kepppfeff/Ladebox-2/KiCAD/README.md

Der Schaltplan wurde mit https://kicad.org/ erstellt.

Ein PCB-Layout gibt es derzeit nicht, da die Schaltung auf einer Lochrasterplatine aufgebaut wurde. Um ein PCB-Layout zu erstellen, müsste der Schaltplan auch noch etwas geändert werden, da im Moment alle Komponenten dargestellt sind, auch die, welche gar nicht auf die Platine gehören. Diese müssten somit durch entsprechende Anschlussklemmen bzw. Steckverbinder ersetzt werden. 

Falls jemand Lust haben sollte, ein solches PCB-Layout zu erstellen (ich habe es derzeit nicht vor) und dieses hier zu veröffentlichen, gerne bei mir melden!
