kepppfeff/Ladebox-2/Bilder/ZOE Box Vorderseite.JPG

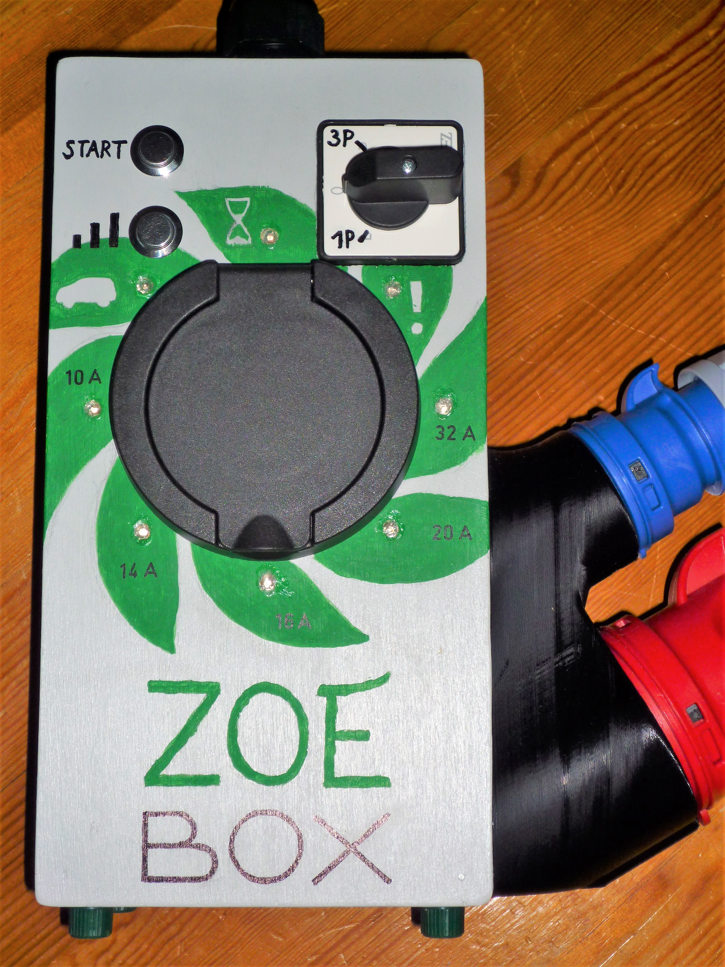
Bilder/ZOE Box Vorderseite.JPG
