kepppfeff/Ladebox-2/Teile und Preise Ladebox 2.6.xlsx

Teileliste: Mobile Ladebox (Hardware-Version 2.6) inkl. 2 Adapterkabel
In der folgenden Tabelle habe ich alle Produkte zusammengestellt, die ich heute kaufen würde, um (noch) eine mobile Ladebox zu bauen.
Teilweise habe ich selbst andere Produkte verwendet als die aufgelisteten, da ich diese gerade da hatte, oder ich habe die aufgelisteten Produkte bei anderen Händlern bestellt.
Daher keine Garantie, dass alle Produkte korrekt ausgewählt sind und alle Links stimmen.
Sollte irgendetwas nicht korrekt sein, würde ich mich über eine Nachricht freuen, damit ich dies korrigieren kann.
Ich habe überall, wo es mir möglich war, Links zu möglichst günstigen Online-Angeboten hinzugefügt (es sind übrigens keine Affiliate-Links) und die entsprechenden Preise angegeben.
Die Preise können sich selbstverständlich bei den Online-Shops jederzeit ändern und sind somit nur für einen groben Überblick gedacht.
Die Versandkosten habe ich pro Shop jeweils nur einmal eingetragen (fett) und bei allen weiteren Produkten mit 0,00 € berechnet.
Einige Produkte habe ich von chinesischen Händlern über AliExpress ausgewählt. Alle kosten (deutlich) unter 22 € und sind damit frei von Einfuhrumsatzsteuer.
Der Versand dauert in der Regel mehrere Wochen. Falls eine Bestellung aus China nicht erwünscht ist, habe ich unten passende Alternativen aufgelistet.
Verwen-dungszweck | Bezeichung | Anz. | Einzel-preis | Versand | Gesamt-preis | Bezugsquelle | Artikelnummer | Weblink
Strom-versorgung der Steuer-platine | DC/DC-Step-Down-Wandler (Eingang 6,8–28 V, Ausgang 5V 500 mA) | 1 | 2.73 € | 5.80 € | 8.53 € | Reichelt / Voelkner | LC78_05-0.5 / X728901 | https://www.reichelt.de/dc-dc-wandler-2-5-w-5-v-500-ma-to-220-lc78-05-0-5-p242823.html oder https://www.voelkner.de/products/1038823/Gaptec-LC7805-0.5-DC-DC-Wandler-Print-12-V-DC-5-V-DC-500mA-2.5W-Anzahl-Ausgaenge-1-x.html
 | Mean Well Netzteil APV-8-12 (12 V, 8 W) | 1 | 4.60 € | 5.95 € | 10.55 € | Voelkner | W201541 | https://www.voelkner.de/products/902679/Mean-Well-APV-8-12-LED-Trafo-Konstantspannung-8W-0-0.67A-12-V-DC-nicht-dimmbar-Ueberlastschutz.html
 | Ladungspumpe ICL7660A (nicht ICL7660 !) | 1 | 1.36 € | 0.00 € | 1.36 € | Reichelt | ICL 7660 ACPAZ | https://www.reichelt.de/dc-dc-einstellbar-1-5--12-v-1-5--12-v-dil-8-icl-7660-acpaz-p188882.html
 | Keramik-(Stütz-)Kondensator 100 nF | 3 | 0.05 € | 0.00 € | 0.15 € | Reichelt | KERKO 100N | https://www.reichelt.de/keramik-kondensator-100n-kerko-100n-p9265.html
 | Elektrolyt-Kondensator 22 μF, low ESR | 4 | 0.09 € | 0.00 € | 0.36 € | Reichelt | RAD FR 22/50 | https://www.reichelt.de/elko-radial-22-uf-50-v-105-c-low-esr-rad-fr-22-50-p121288.html
Stecker-verrie-gelung | Relais, 1 Wechsler, Spule 12 V/DC | 2 | 0.67 € | 0.00 € | 1.34 € | Reichelt | HJR-4102-L 12V | https://www.reichelt.de/dil-miniaturrelais-hjr-4102-12v-1-wechsler-5a-hjr-4102-l-12v-p101951.html
 | Elektrolyt-Kondensator 4700 μF, low ESR | 1 | 0.90 € | 0.00 € | 0.90 € | Voelkner | D05780 | https://www.voelkner.de/products/543368/Panasonic-EEUFR1C472B-Elektrolyt-Kondensator-radial-bedrahtet-7.5mm-4700-F-16V-20-x-H-16mm-x-25mm-1St..html
 | NPN-Transistor BD139 (1,5 A) | 1 | 0.14 € | 0.00 € | 0.14 € | Reichelt | BD 139-16 | https://www.reichelt.de/bipolartransistor-npn-80v-1-5a-8w-to-126-bd-139-16-p219090.html
 | Verriegelungsaktuator für Typ2-Dose | 1 | 25.00 € | 9.00 € | 34.00 € | Laadkabelwinkel | 99051000801 | https://www.laadkabelwinkel.nl/dsiec-elb-electromagnetic-lock
 | NPN-Transistor BC547C | 3 | 0.02 € | 0.00 € | 0.06 € | Reichelt | BC 547C | https://www.reichelt.de/bipolartransistor-npn-45v-0-1a-0-5w-to-92-bc-547c-p5007.html
 | Widerstand 2,2 Ω | 1 | 0.04 € | 0.00 € | 0.04 € | Reichelt | VI MBB02070C2208 | https://www.reichelt.de/duennschichtwiderstand-axial-0-6-w-2-2-ohm-1--vi-mbb02070c2208-p233710.html
 | Schottky-Diode 1N5817 | 1 | 0.02 € | 0.00 € | 0.02 € | Reichelt | RND 1N5817 | https://www.reichelt.de/schottkydiode-20-v-1-a-do-41-rnd-1n5817-p223383.html
Erzeugung und Auswertung Pilotsignal | Komparator LM393 (2-fach) | 1 | 0.18 € | 0.00 € | 0.18 € | Reichelt | LM 393 DIP | https://www.reichelt.de/komparator-2-fach-dip-8-lm-393-dip-p10510.html
 | Operationsverstärker LM6132 (2-fach, rail-to-rail) | 1 | 3.36 € | 0.00 € | 3.36 € | Reichelt | LM 6132 BIN | https://www.reichelt.de/operationsverstaerker-dual-10-mhz-dil-8-lm-6132-bin-p187779.html
 | Schottky-Diode BAT85 | 2 | 0.08 € | 0.00 € | 0.16 € | Reichelt | BAT 85 | https://www.reichelt.de/schottkydiode-30-v-0-2-a-do-35-bat-85-p4857.html
 | PNP-Transistor BC557B | 1 | 0.02 € | 0.00 € | 0.02 € | Reichelt | BC 557B | https://www.reichelt.de/bipolartransistor-pnp-45v-0-1a-0-5w-to-92-bc-557b-p35845.html
Bedienung und Anzeige | LED grün | 8 | 0.06 € | 0.00 € | 0.48 € | Reichelt | RND 135-00172 | https://www.reichelt.de/led-5-mm-gelb-gruen-einfarbig-1700-mcd-15--rnd-135-00172-p263822.html
 | Taster – Metallgehäuse muss geerdet werden! | 2 | 4.60 € | 0.00 € | 9.20 € | Voelkner | D79675 oder D79021 | https://www.voelkner.de/products/73350/TRU-Components-GQ16F-10-J-N-Vandalismusgeschuetzter-Drucktaster-48-V-DC-2A-1-x-Aus-Ein-IP65-tastend-1St..html oder https://www.voelkner.de/products/73410/TRU-Components-GQ16B-10-J-N-Vandalismusgeschuetzter-Drucktaster-48-V-DC-2A-1-x-Aus-Ein-IP65-tastend-1St..html
 | Schalter 3 × Ein-Aus-Ein (3 Wechsler) – Metallgehäuse muss geerdet werden! | 1 | 6.70 € | 0.00 € | 6.70 € | Voelkner | D77757 oder D73953 | https://www.voelkner.de/products/41958/APEM-5559A-55590003-Kippschalter-250-V-AC-3A-3-x-Ein-Aus-Ein-rastend-0-rastend-1St..html oder https://www.voelkner.de/products/43531/Eledis-1A33-NF1STSE-Kippschalter-250-V-AC-2A-3-x-Ein-Aus-Ein-rastend-0-rastend-1St..html
Allge-meines | Chinesischer Arduino Nano Klon | 1 | 1.75 € | 0.00 € | 1.75 € | AliExpress | 32855188188 | z.B. https://de.aliexpress.com/item/32855188188.html (eine der Varianten mit 328P wählen)
 | Widerstände (8× 150 Ω, 4× 1 kΩ, 2× 4,7 kΩ, 3× 22 kΩ, 3× 68 kΩ, 1× 82 kΩ, 3× 120 kΩ, 1× 220 kΩ) | 25 | 0.03 € | 0.00 € | 0.75 € | Reichelt | VI MBB02070C… | https://www.reichelt.de/Duennschichtwiderstaende/2/index.html?ACTION=2&LA=2&GROUPID=8367
 | Silizium-Diode 1N4007 | 7 | 0.02 € | 0.00 € | 0.14 € | Reichelt | 1N 4007 DIO | https://www.reichelt.de/gleichrichterdiode-1000-v-1-a-do-41-1n-4007-dio-p219368.html
 | Verbrauchsmaterial (Aderendhülsen, Schrumpfschläuche, Drähte, Lötzinn usw.) | ? | ? | ? | 3.00 € | ? |  | Nach Bedarf, Preis geschätzt
Platine und elektrische Verbin-dungen | IC-Sockel DIP-8 (falls gewünscht) | 3 | 0.04 € | 0.00 € | 0.12 € | Reichelt | GS 8 | https://www.reichelt.de/ic-sockel-8-polig-doppelter-federkontakt-gs-8-p8230.html
 | Lochrasterplatine | 1 | 1.99 € | 0.00 € | 1.99 € | Reichelt | H25PR150 | https://www.reichelt.de/lochrasterplatine-hartpapier-150x100mm-h25pr150-p8271.html
 | Ein Schwung Buchsenleisten 1 × 15 für Arduino Nano (2 Stück werden benötigt) | 1 | 0.30 € | 1.00 € | 1.30 € | AliExpress | ? | Hier suchen: https://de.aliexpress.com/wholesale?trafficChannel=main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
 | Klemm- / Schraubblöcke, Steckverbinder und Leitungen | ? | ? | ? | 8.00 € | ? |  | Nach Bedarf, Preis geschätzt
Netz-spannungs-Teile | Typ2-Ladesteckdose 32 A (mit Schraubanschlüssen) | 1 | 90.00 € | 0.00 € | 90.00 € | Laadkabelwinkel | 99051000781 | https://www.laadkabelwinkel.nl/type-2-socket-16a-32a-schroefverbinding
 | Wago-Klemme 221-415 (5 × bis 4 mm²) | 1 | 0.81 € | 0.00 € | 0.81 € | Reichelt / Voelkner | WAGO 221-415 / Q661261 | https://www.reichelt.de/verbindungsklemme-5-leiteranschluss-wago-221-415-p149800.html oder https://www.voelkner.de/products/699424/WAGO-Verbindungsklemme-flexibel-0.14-4mm-starr-0.2-4mm-Polzahl-5-221-415-1-St.-Transparent-Orange.html
 | Wago-Klemme 221-413 (3 × bis 4 mm²) | 4 | 0.50 € | 0.00 € | 2.00 € | Reichelt / Voelkner | WAGO 221-413 / Q661241 | https://www.reichelt.de/verbindungsklemme-3-leiteranschluss-wago-221-413-p149799.html oder https://www.voelkner.de/products/699423/WAGO-221-413-1-Verbindungsklemme-flexibel-0.14-4mm-starr-0.2-4mm-Polzahl-3-Transparent-Orange.html
 | Wago-Klemme 222-413 (3 × bis 2,5 mm²) | 3 | 0.39 € | 0.00 € | 1.17 € | Reichelt / Voelkner | WAGO 222-413 / S55241 | https://www.reichelt.de/verbindungsdosenklemme-3-fach-0-08-4-0mm--wago-222-413-p54547.html oder https://www.voelkner.de/products/2306/WAGO-Verbindungsklemme-flexibel-0.08-4mm-starr-0.08-2.5mm-Polzahl-3-222-413-1-St.-Grau-Orange.html
 | Doepke DFS 4 040-4/0,03-A EV (9134818) | 1 | 253.33 € | 6.90 € | 260.23 € | VOLTUS | 1683383 | https://www.voltus.de/elektromaterial/e-mobilitaet/doepke/doepke-09134818-dfs-4-040-4-0-03-a-ev-fehlerstromschutzschalter-typ-a-4-polig-40a.html
 | Schmelzsicherung 400 mA träge | 1 | 0.22 € | 0.00 € | 0.22 € | Reichelt | MIK-TR 0,4A | https://www.reichelt.de/kleinstsicherung-kurz-traege-0-4a-mik-tr-0-4a-p125191.html
Gehäuse | Holzteile und Schrauben | ? | ? | ? | 8.00 € | Baumarkt des Vertrauens
 | Kabelverschraubung M25 (für 5 × 4 mm²) | 1 | 0.35 € | 0.00 € | 0.35 € | Reichelt | MBF 25 | https://www.reichelt.de/metrische-kabelverschraubung-11-0-17-0-mm-m25-grau-mbf-25-p44828.html
 | Gegenmutter für Kabelverschr. M25 | 1 | 0.10 € | 0.00 € | 0.10 € | Reichelt | MGM 25 | https://www.reichelt.de/metrische-gegenmutter-fuer-mbf-25-m25-grau-mgm-25-p44833.html
 | Kabelverschraubung M20 (für 3 × 2,5 mm²) | 1 | 0.25 € | 0.00 € | 0.25 € | Reichelt | MBF 20 | https://www.reichelt.de/metrische-kabelverschraubung-8-0-13-0-mm-m20-grau-mbf-20-p44827.html
 | Gegenmutter für Kabelverschr. M20 | 1 | 0.07 € | 0.00 € | 0.07 € | Reichelt | MGM 20 | https://www.reichelt.de/metrische-gegenmutter-fuer-mbf-20-m20-grau-mgm-20-p44832.html
Anschluss- und Adapter-kabel | Drehstrom-Stecker CEE32 (rot) | 1 | 4.20 € | 0.00 € | 4.20 € | Reichelt | CEE-STECKER 2-32 | https://www.reichelt.de/5-poliger-cee-stecker-400v-32a-rot-cee-stecker-2-32-p29106.html
 | Camping-Stecker CEE16 (blau) | 1 | 2.30 € | 0.00 € | 2.30 € | Voelkner | X96210 | https://www.voelkner.de/products/80233/PCE-172500009-CEE-CARA-Stecker-16A-3polig-230V.html
 | Drehstrom-Stecker CEE16 (rot) | 1 | 2.65 € | 0.00 € | 2.65 € | Reichelt | CEE-STECKER 2-16 | https://www.reichelt.de/cee-stecker-400v-16a-rot-5-polig-cee-stecker-2-16-p29105.html
 | Drehstrom-Kupplung CEE32 (rot) | 1 | 4.00 € | 0.00 € | 4.00 € | Voelkner / Reichelt | X96291 / CEE-KUPP 2-32 | https://www.voelkner.de/products/8020/PCE-225-6-CEE-Kupplung-32A-5polig-400V.html oder https://www.reichelt.de/cee-kupplung-400v-32a-rot-cee-kupp-2-32-p29109.html
 | Camping-Kupplung CEE16 (blau) | 1 | 3.00 € | 0.00 € | 3.00 € | Voelkner / Reichelt | X96234 / CEE-KUPP 1-16 | https://www.voelkner.de/products/80234/PCE-182400003-CEE-CARA-Kupplung-16A-3polig-230V.html oder https://www.reichelt.de/cee-kupplung-230v-16a-blau-cee-kupp-1-16-p29107.html
 | Schutzkontaktstecker (CEE 7/7, kompa-tibel auch mit französischen Steckdosen) | 1 | 2.20 € | 0.00 € | 2.20 € | Reichelt | TAUR2 0521-SR | https://www.reichelt.de/gummi-stecker-taurus2-typ-ef-cee-7-7-schwarz-rot-taur2-0521-sr-p277259.html
 | Gummileitung 5 × 4 mm² (Meterware) | 1 | 4.36 € | 0.00 € | 4.36 € | VOLTUS | 1010909 | https://www.voltus.de/elektromaterial/kabel/gummi-leitung/schwer-h07rnf/h07rn-f-5g4qmm-gummischlauchleitungen-schwere-nennspannung-450-750v-meterware.html
 | Gummileitung 5 × 2,5 mm² (Meterware) | 1 | 2.20 € | 0.00 € | 2.20 € | VOLTUS | 1010907 | https://www.voltus.de/elektromaterial/kabel/gummi-leitung/schwer-h07rnf/h07rn-f-5g2-5qmm-gummischlauchleitungen-schwere-nennspannung-450-750v-meterware.html
 | Gummileitung 3 × 2,5 mm² (Meterware) | 2 | 1.40 € | 0.00 € | 2.80 € | VOLTUS | 1010882 | https://www.voltus.de/elektromaterial/kabel/gummi-leitung/schwer-h07rnf/h07rn-f-3g2-5qmm-gummischlauchleitungen-schwere-nennspannung-450-750v.html
Schalten des Ladestroms | Schütz ABB ESB 40-40 230AC/DC | 1 | 25.00 € | 5.00 € | 30.00 € | ? |  | https://www.idealo.de/preisvergleich/OffersOfProduct/1192024_-esb-40-40-230vac-dc-abb-stotz-striebel-john.html
 | Relais, 1 Schließer, 30 A, Spule 12 V/DC | 2 | 1.10 € | 0.00 € | 2.20 € | Voelkner | W225001 | https://www.voelkner.de/products/942274/SHA-T90-SHA-12VDC-S-A-4pin-Printrelais-12-V-DC-30A-1-Schliesser-1St..html
 | Relais, 1 Schließer, Spule 12 V/DC | 1 | 0.67 € | 0.00 € | 0.67 € | Reichelt | HJR-4102-L 12V | https://www.reichelt.de/dil-miniaturrelais-hjr-4102-12v-1-wechsler-5a-hjr-4102-l-12v-p101951.html
 | NPN-Transistor BC337-40 | 1 | 0.03 € | 0.00 € | 0.03 € | Reichelt | BC 337-40 | https://www.reichelt.de/bipolartransistor-npn-45v-0-8a-0-625w-to-92-bc-337-40-p4987.html
 | Gesamtkosten: |  |  | 518.41 €
Alternative Produkte
 | Bezeichung | Anz. | Einzel-preis | Versand | Gesamt-preis | Bezugsquelle | Artikelnummer | Weblink
Folgende Produkte können verwendet werden, falls nicht bei chinesischen Händlern bestellt werden soll:
Statt Zeile 40 | Alternative 1: Chinesischer Arduino-Nano-Klon von deutschem Händler | 1 | 3.85 € | 0.00 € | 3.85 € | eBay | 274450834212 | https://www.ebay.de/itm/274450834212
 | Alternative 2: Marken-Arduino-Nano-Klon | 1 | 11.55 € | 0.00 € | 11.55 € | Reichelt | ARD NANO V3 | https://www.reichelt.de/arduino-kompatibles-nano-board-atmega328-mini-usb-ard-nano-v3-p225690.html
 | Alternative 3: Original Arduino Nano | 1 | 17.00 € | 0.00 € | 17.00 € | Reichelt | ARDUINO NANO | https://www.reichelt.de/arduino-nano-v3-3-atmega-328-mini-usb-arduino-nano-p142943.html
Statt Zeile 47 | Zwei Buchsenleisten 1 × 15 für Arduino Nano (Mindestbestellmenge: 10) | 10 | 0.30 € | 0.00 € | 3.00 € | Voelkner | W052741 | https://www.voelkner.de/products/955307/Econ-Connect-Buchsenleiste-Standard-Anzahl-Reihen-1-Polzahl-je-Reihe-15-BLG1X15-1St..html
Die folgenden Bauteile können anstatt der fest verlöteten Schmelzsicherung (Zeile 55) verwendet werden, um die Sicherung bei Auslösung einfacher austauschen zu können:
 | Sicherungshalter Printmontage | 1 | 0.19 € | 0.00 € | 0.19 € | Reichelt | RND 170-00188 | https://www.reichelt.de/sicherungshalter-fuer-5-x-20-mm-250-v-6-3-a-gruen-rnd-170-00188-p253173.html
 | Feinsicherung 5 × 20 mm, 400 mA träge | 1 | 0.32 € | 0.00 € | 0.32 € | Reichelt | TR 0,4A | https://www.reichelt.de/feinsicherung-5x20mm-traege-0-4a-tr-0-4a-p21783.html
