kepppfeff/Ladebox-2/Schaltplan Ladebox 2.6.pdf

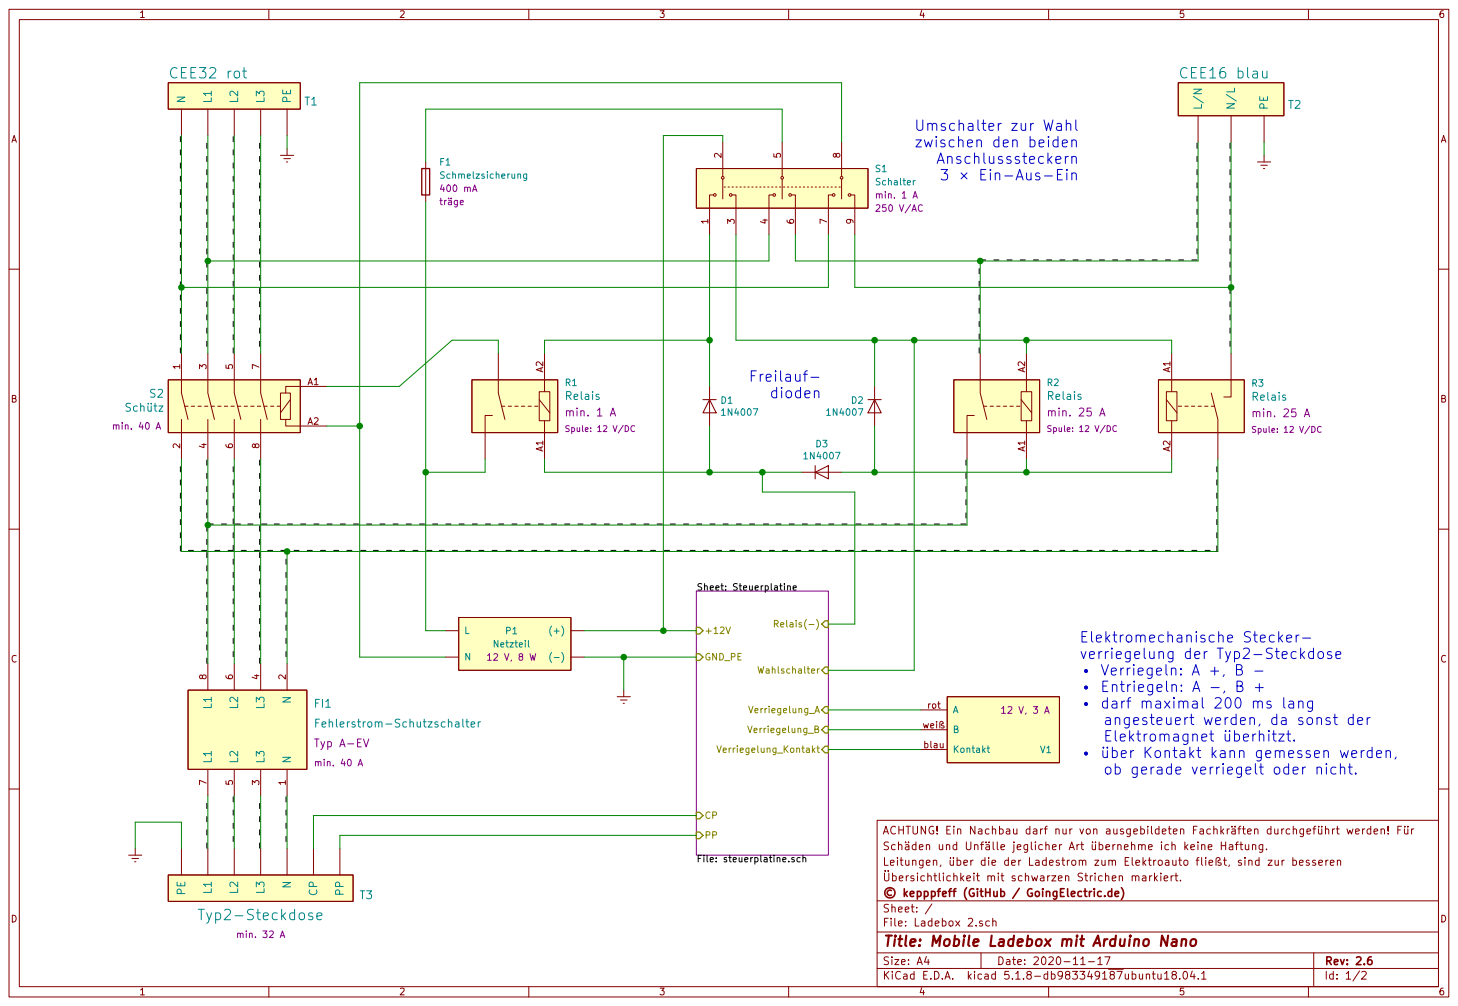
[picture p8: page 1]

Elektromechanische Stecker-
verriegelung der Typ2-Steckdose
Verriegeln: A +, B -
Entriegeln: A -, B +
darf maximal 200 ms lang
angesteuert werden, da sonst der
Elektromagnet überhitzt.
über Kontakt kann gemessen werden,
ob gerade verriegelt oder nicht.

File: steuerplatine.sch CP

ACHTUNG! Ein Nachbau darf nur von ausgebildeten Fachkräften durchgeführt werden! Für
Schäden und Unfälle jeglicher Art übernehme ich keine Haftung.
Leitungen, über die der Ladestrom zum Elektroauto fließt, sind zur besseren
Übersichtlichkeit mit schwarzen Strichen markiert.
File: Ladebox 2.sch Sheet: / © kepppfeff (GitHub / GoingElectric.de)

Id: 1/2 Title: Mobile Ladebox mit Arduino Nano

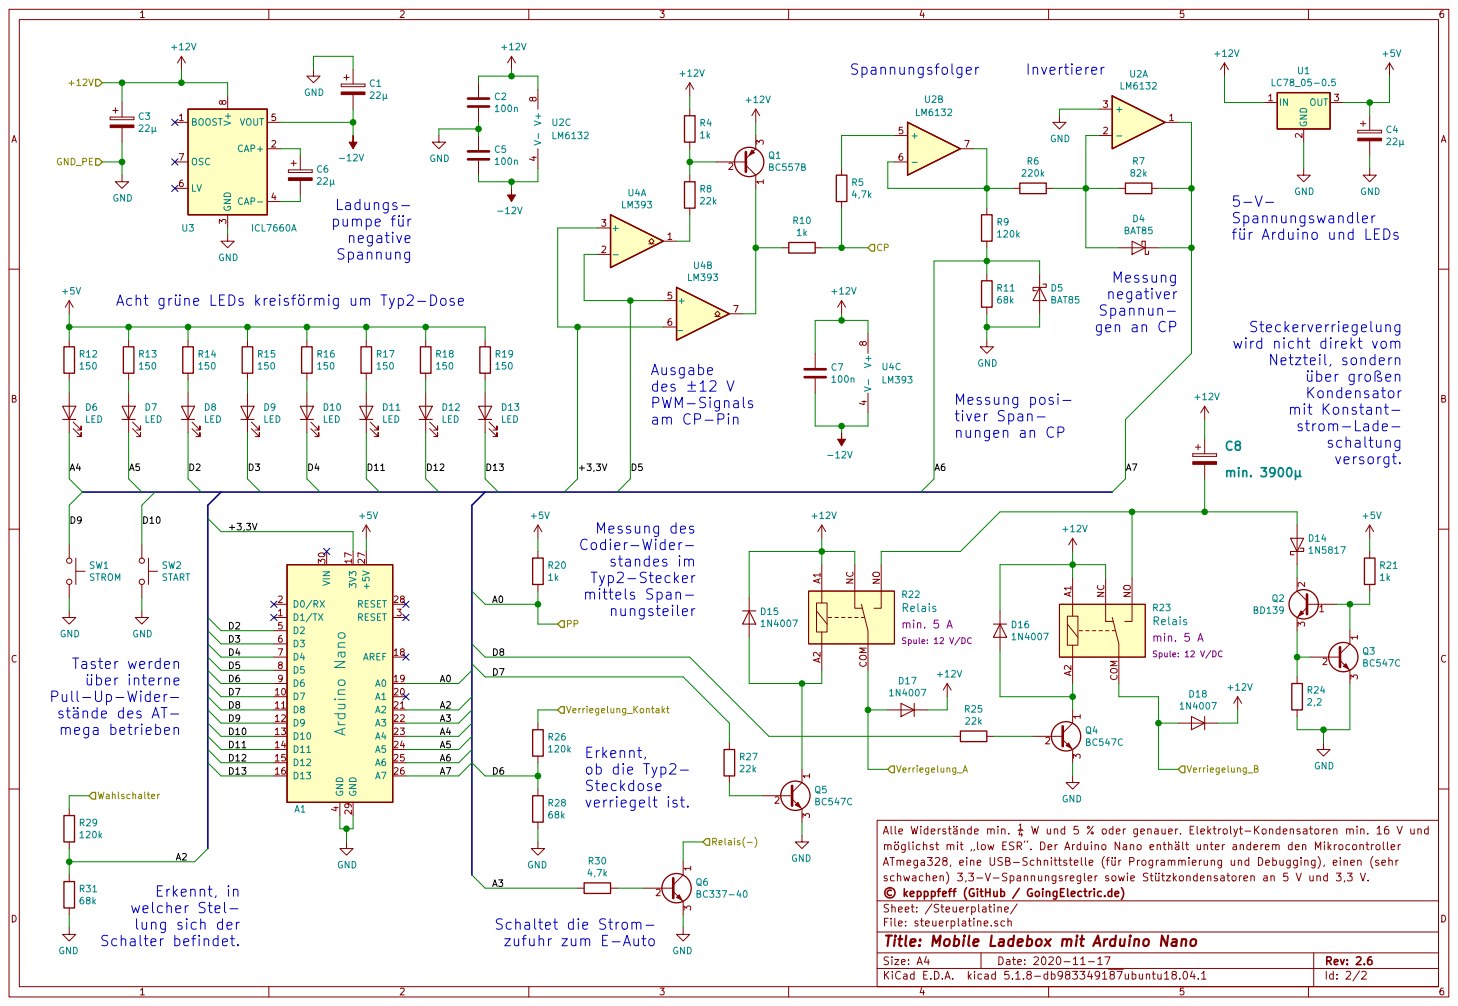
[picture p9: page 2]

R22 Relais Spule: 12 V/DC min. 5 A V- 4 V+

Acht grüne LEDs kreisförmig um Typ2-Dose

Alle Widerstände min. ¼ W und 5 % oder genauer. Elektrolyt-Kondensatoren min. 16 V und D10
LED

R23 Relais Spule: 12 V/DC min. 5 A

möglichst mit low ESR. Der Arduino Nano enthält unter anderem den Mikrocontroller
ATmega328, eine USB-Schnittstelle (für Programmierung und Debugging), einen (sehr
schwachen) 3,3-V-Spannungsregler sowie Stützkondensatoren an 5 V und 3,3 V.
© kepppfeff (GitHub / GoingElectric.de)
Sheet: /Steuerplatine/
File: steuerplatine.sch
Id: 2/2 Title: Mobile Ladebox mit Arduino Nano
