kepppfeff/Ladebox-2/KiCAD/Ladebox 2.sch

## KiCad design KiCAD/Ladebox 2.sch (2020-11-17)

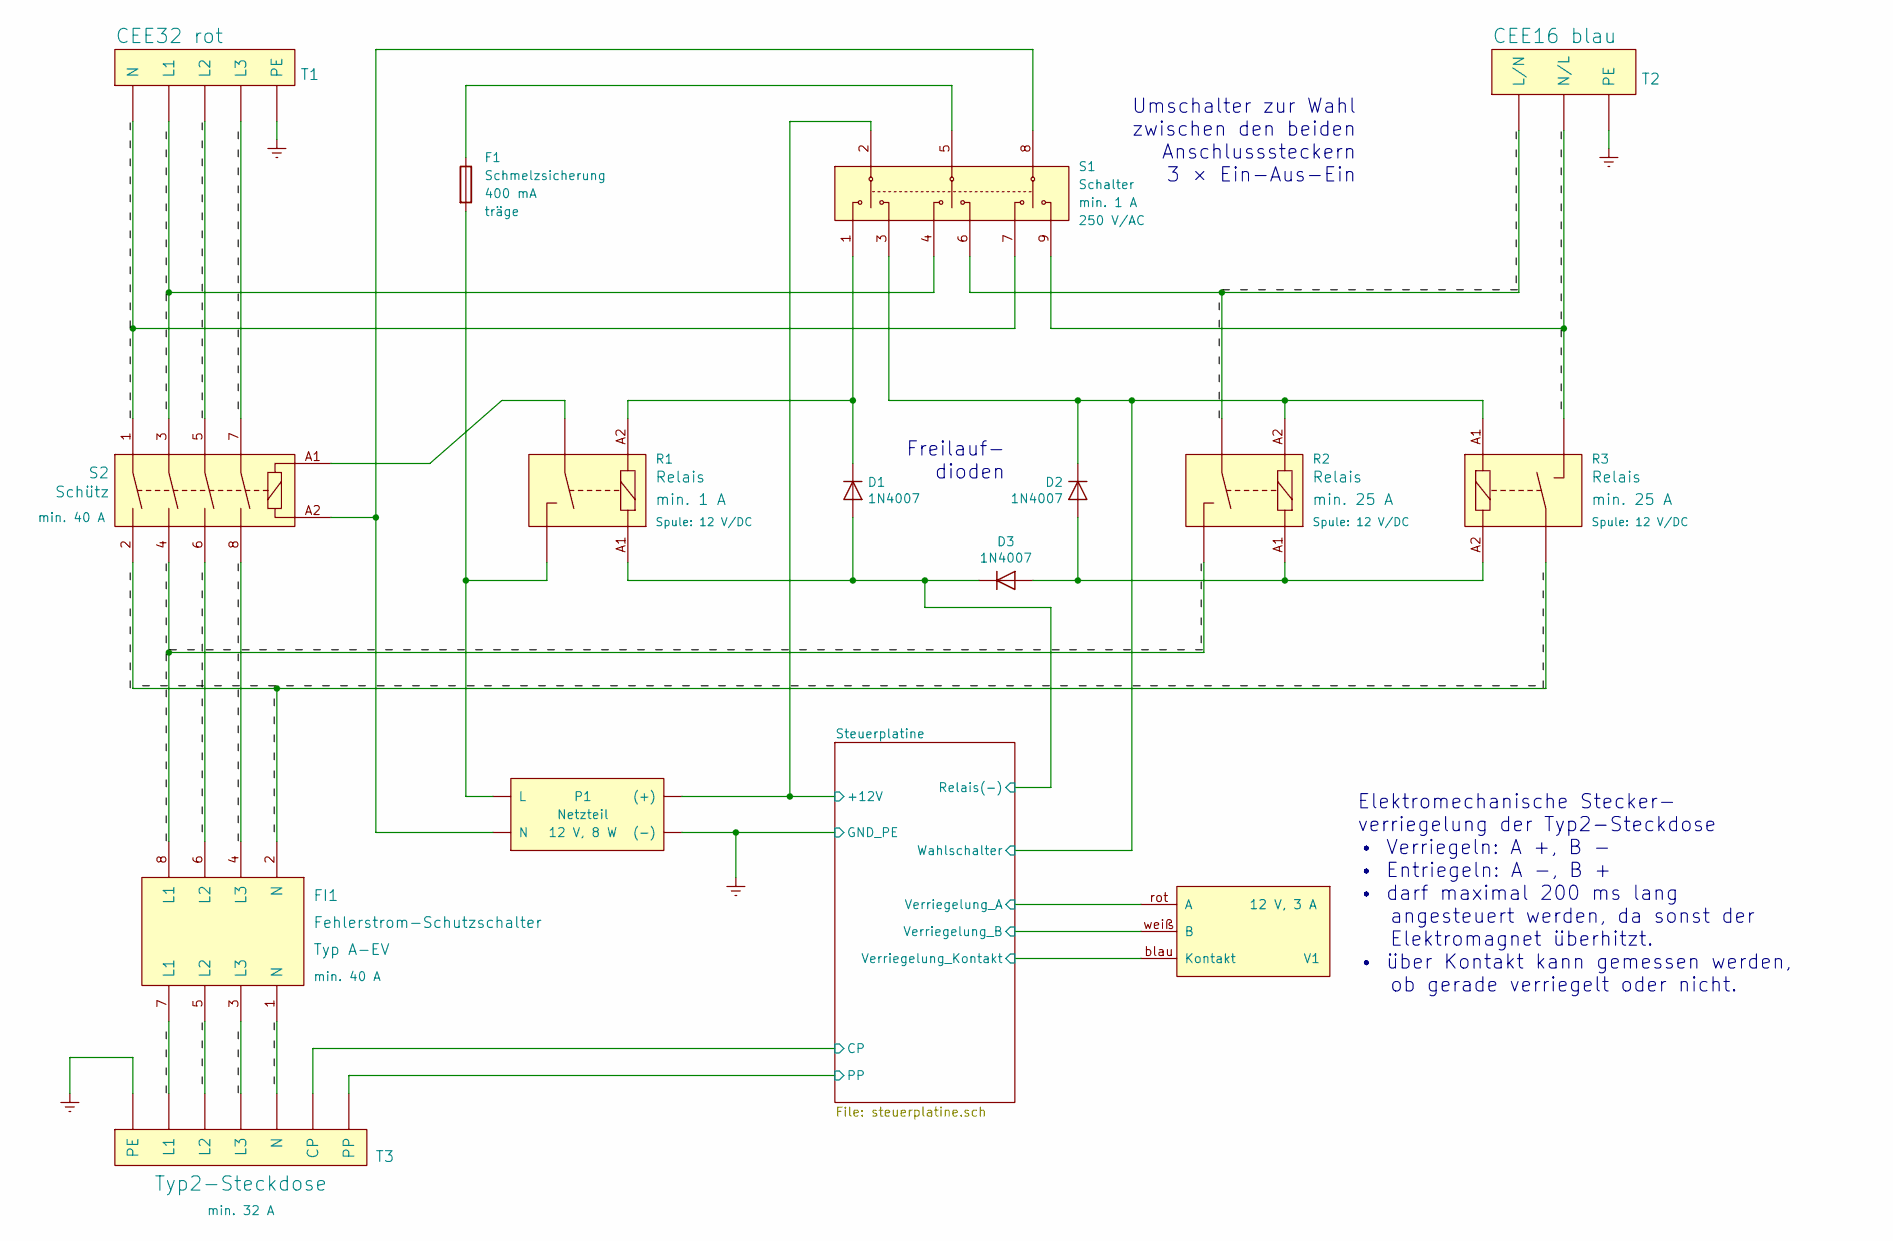
[picture p10: schematic Ladebox 2.sch]

Parts:
D1, D2, D3: 1N4007
F1: Schmelzsicherung
FI1: Fehlerstrom-Schutzschalter
P1: Netzteil
R1, R2, R3: Relais
S1: Schalter
S2: Schütz
T1: CEE32 rot
T2: CEE16 blau
T3: Typ2-Steckdose
V1: Verriegelung

Connections:
+12V: P1.~, S1.2
CP: T3.~
Earth: P1.~, T1.~, T2.~, T3.~
unnamed: D1.1 (K), R1.A2, S1.1
unnamed: D2.2 (A), D3.2 (A), R2.A1, R3.A2
unnamed: F1.1, S1.5
unnamed: F1.2, P1.~, R1.~
unnamed: P1.~, S1.8, S2.A2
unnamed: R1.~, S2.A1
PP: T3.~
Relais(-): D1.2 (A), D3.1 (K), R1.A1
Verriegelung_A: V1.rot (A)
Verriegelung_B: V1.weiß (B)
Verriegelung_Kontakt: V1.blau (Kontakt)
Wahlschalter: D2.1 (K), R2.A2, R3.A1, S1.3
_: FI1.1 (N), FI1.2 (N), FI1.3 (L3), FI1.4 (L3), FI1.5 (L2), FI1.6 (L2), FI1.7 (L1), FI1.8 (L1), R2.~, R3.~, S1.4, S1.6, S1.7, S1.9, S2.1, S2.2, S2.3, S2.4, S2.5, S2.6, S2.7, S2.8, T1.~, T2.~, T3.~

Notes on the sheet:
Elektromechanische Stecker- verriegelung der Typ2-Steckdose • Verriegeln: A +, B - • Entriegeln: A -, B + • darf maximal 200 ms lang angesteuert werden, da sonst der Elektromagnet überhitzt. • über Kontakt kann gemessen werden, ob gerade verriegelt oder nicht.
Umschalter zur Wahl zwischen den beiden Anschlusssteckern 3 × Ein-Aus-Ein
Freilauf- dioden
