kepppfeff/Ladebox-2/KiCAD/steuerplatine.sch

## KiCad design KiCAD/steuerplatine.sch (2020-11-17)

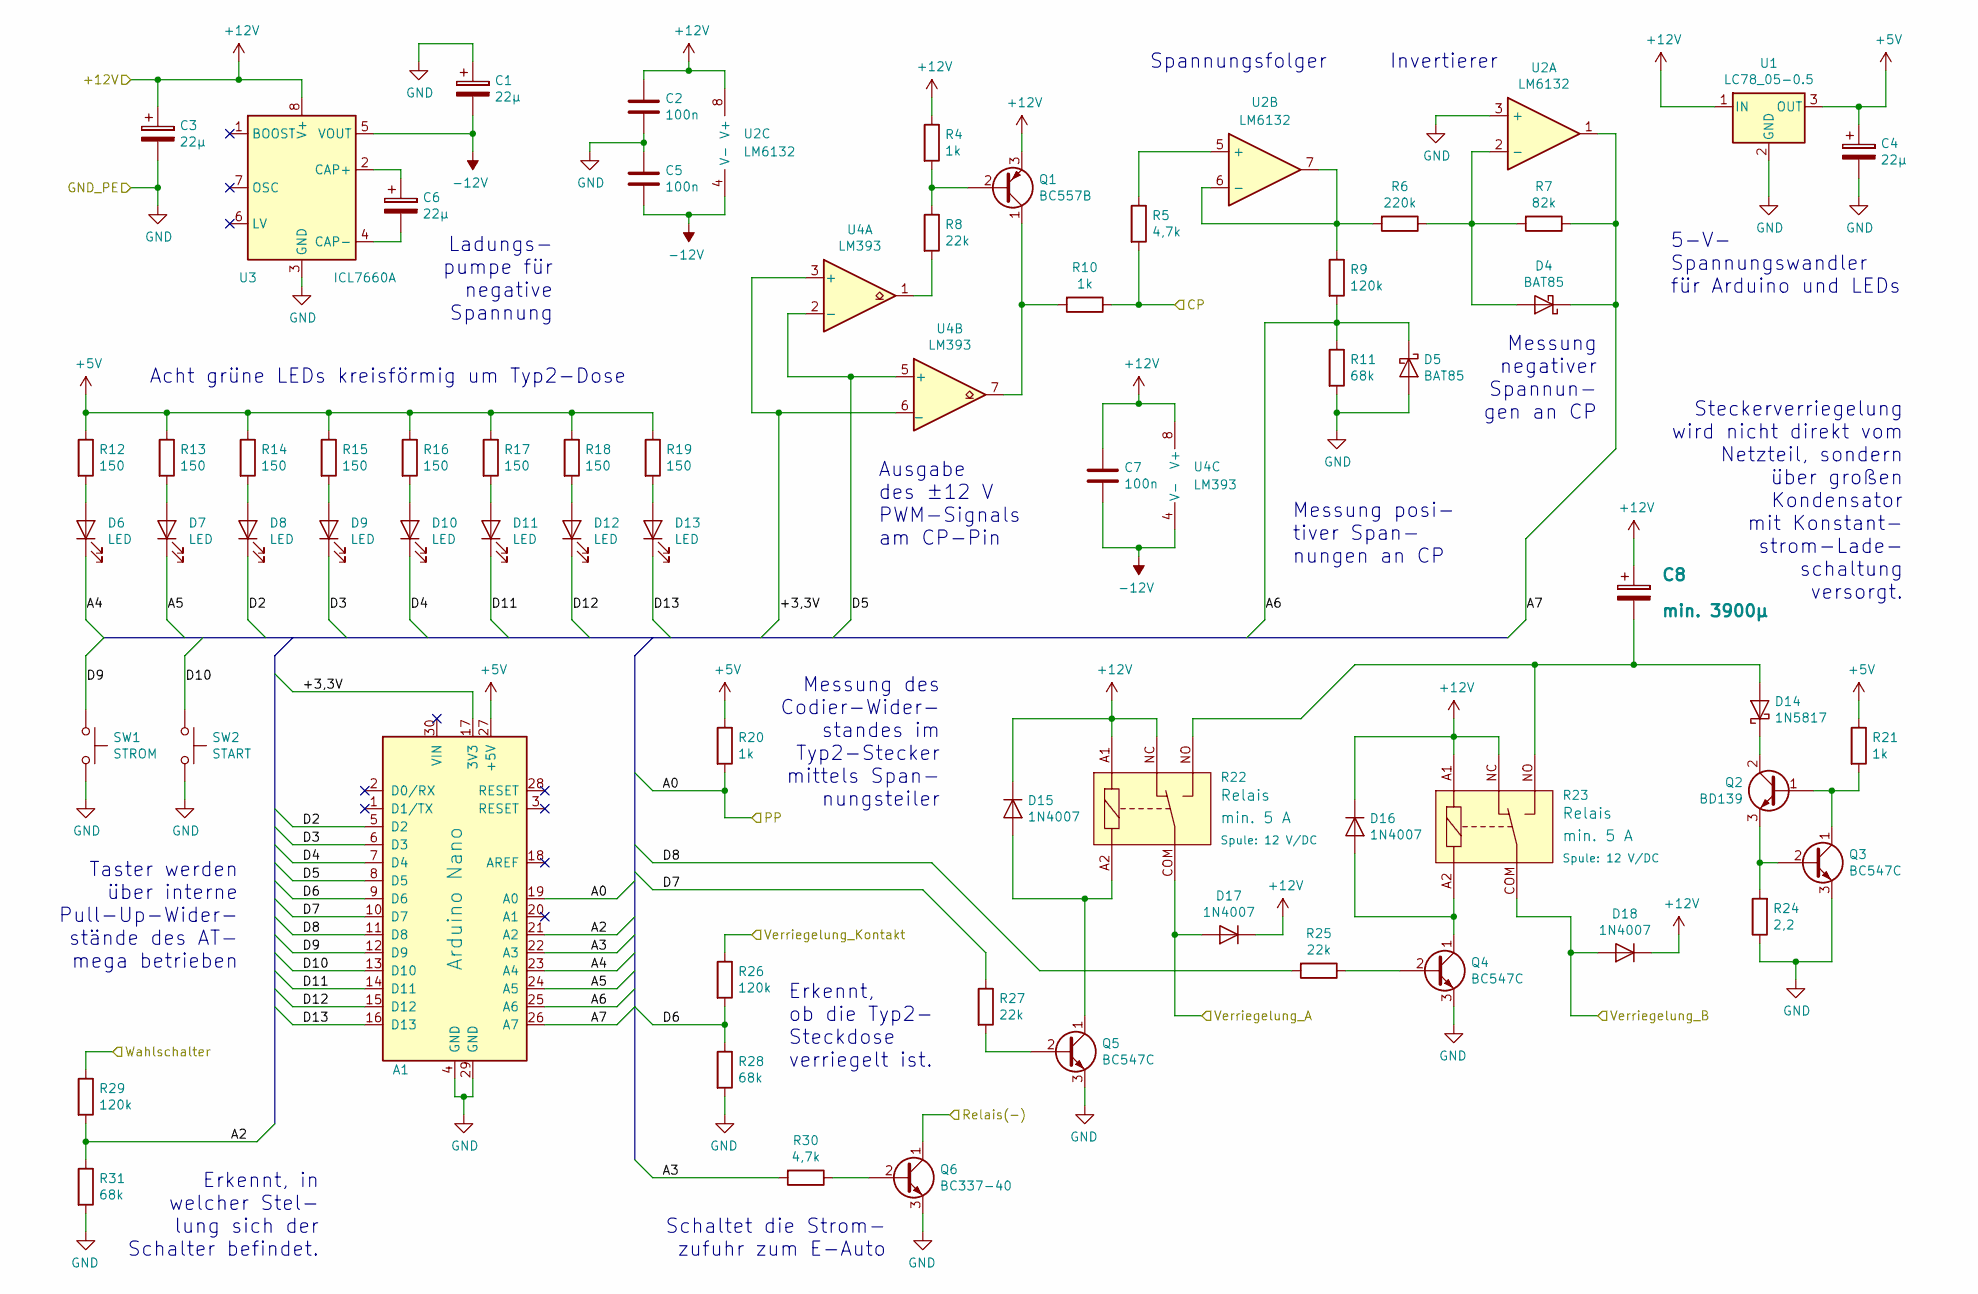
[picture p11: schematic steuerplatine.sch]

Parts:
A1: Arduino Nano; Arduino_Nano
C1, C3, C4, C6: 22μ
C2, C5, C7: 100n
C8: min. 3900μ
D4, D5: BAT85
D6, D7, D8, D9, D10, D11, D12, D13: LED
D14: 1N5817
D15, D16, D17, D18: 1N4007
Q1: BC557B
Q2: BD139
Q3, Q4, Q5: BC547C
Q6: BC337-40
R4, R10, R20, R21: 1k
R5, R30: 4,7k
R6: 220k
R7: 82k
R8, R25, R27: 22k
R9, R26, R29: 120k
R11, R28, R31: 68k
R12, R13, R14, R15, R16, R17, R18, R19: 150
R22, R23: Relais
R24: 2,2
SW1: STROM
SW2: START
U1: LC78_05-0.5; Converter_DCDC_RECOM_R-78E-0.5_THT
U2: LM6132
U3: ICL7660A; DIP-8_W7.62mm
U4: LM393

Connections:
+3,3V: A1.17 (3V3), U4.3 (+), U4.6 (_)
+5V: A1.27 (+5V), C4.1, R12.1, R13.1, R14.1, R15.1, R16.1, R17.1, R18.1, R19.1, R20.1, R21.1, U1.3 (OUT)
+12V: C2.1, C3.1, C7.1, C8.1, D15.1 (K), D16.1 (K), D17.1 (K), D18.1 (K), Q1.3 (E), R4.1, R22.A1, R22.NC, R23.A1, R23.NC, U1.1 (IN), U2.8 (V+), U3.8 (V+), U4.8 (V+)
-12V: C1.2, C5.2, C7.2, U2.4 (V-), U3.5 (VOUT), U4.4 (V-)
A0: A1.19 (A0), R20.2
A2: A1.21 (A2), R29.2, R31.1
A3: A1.22 (A3), R30.2
A4: A1.23 (A4), D6.1 (K)
A5: A1.24 (A5), D7.1 (K)
A6: A1.25 (A6), D5.1 (K), R9.2, R11.1
A7: A1.26 (A7), D4.1 (K), R7.1, U2.1
CP: R5.2, R10.1
D2: A1.5 (D2), D8.1 (K)
D3: A1.6 (D3), D9.1 (K)
D4: A1.7 (D4), D10.1 (K)
D5: A1.8 (D5), U4.2 (-), U4.5 (+)
D6: A1.9 (D6), R26.2, R28.1
D7: A1.10 (D7), R27.1
D8: A1.11 (D8), R25.2
D9: A1.12 (D9), SW1.1
D10: A1.13 (D10), SW2.1
D11: A1.14 (D11), D11.1 (K)
D12: A1.15 (D12), D12.1 (K)
D13: A1.16 (D13), D13.1 (K)
GND: A1.4 (GND), A1.29 (GND), C1.1, C2.2, C3.2, C4.2, C5.1, D5.2 (A), Q3.3 (E), Q4.3 (E), Q5.3 (E), Q6.3 (E), R11.2, R24.1, R28.2, R31.2, SW1.2, SW2.2, U1.2 (GND), U2.3 (+), U3.3 (GND)
unnamed: C6.1, U3.2 (CAP+)
unnamed: C6.2, U3.4 (CAP-)
unnamed: C8.2, D14.2 (A), R22.NO, R23.NO
unnamed: D4.2 (A), R6.1, R7.2, U2.2 (-)
unnamed: D6.2 (A), R12.2
unnamed: D7.2 (A), R13.2
unnamed: D8.2 (A), R14.2
unnamed: D9.2 (A), R15.2
unnamed: D10.2 (A), R16.2
unnamed: D11.2 (A), R17.2
unnamed: D12.2 (A), R18.2
unnamed: D13.2 (A), R19.2
unnamed: D14.1 (K), Q2.2 (C)
unnamed: D15.2 (A), Q5.1 (C), R22.A2
unnamed: D16.2 (A), Q4.1 (C), R23.A2
unnamed: Q1.1 (C), R10.2, U4.7
unnamed: Q1.2 (B), R4.2, R8.1
unnamed: Q2.1 (B), Q3.1 (C), R21.2
unnamed: Q2.3 (E), Q3.2 (B), R24.2
unnamed: Q4.2 (B), R25.1
unnamed: Q5.2 (B), R27.2
unnamed: Q6.2 (B), R30.1
unnamed: R5.1, U2.5 (+)
unnamed: R6.2, R9.1, U2.6 (-), U2.7
unnamed: R8.2, U4.1
Relais(-): Q6.1 (C)
Verriegelung_A: D17.2 (A), R22.COM
Verriegelung_B: D18.2 (A), R23.COM
Verriegelung_Kontakt: R26.1
Wahlschalter: R29.1

Notes on the sheet:
Messung posi- tiver Span- nungen an CP
Ausgabe des ±12 V PWM-Signals am CP-Pin
Erkennt, ob die Typ2- Steckdose verriegelt ist.
Messung des Codier-Wider- standes im Typ2-Stecker mittels Span- nungsteiler
Taster werden über interne Pull-Up-Wider- stände des AT- mega betrieben
Spannungsfolger
Messung negativer Spannun- gen an CP
Steckerverriegelung wird nicht direkt vom Netzteil, sondern über großen Kondensator mit Konstant- strom-Lade- schaltung versorgt.
Acht grüne LEDs kreisförmig um Typ2-Dose
Ladungs- pumpe für negative Spannung
Invertierer
Erkennt, in welcher Stel- lung sich der Schalter befindet.
Schaltet die Strom- zufuhr zum E-Auto
5-V- Spannungswandler für Arduino und LEDs
